krutikdg/airMouse/BOM.csv

Component | Quantity | Price/Unit (USD) | Purpose | Purchase Link
Seeed XIAO ESP32S3 (non-Sense version) | 1 | 27.20 | Main controller with Bluetooth LE and LiPo charging; the code and pin map assume this board | https://www.amazon.in/ESP32S3-2-4GHz-Wi-Fi-Dual-core-Supported-Efficiency-Interface/dp/B0BYSB66S5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
GY-521 MPU6050 gyro and accelerometer breakout | 1 | 8.55 | Reads wrist rotation to move the cursor | https://www.amazon.in/Gyroscope-Accelerometer-Interface-Tracking-Robotics/dp/B0H1JYZHGC
Mini analog thumb joystick module with push switch | 1 | 1.50 | Scroll on both axes and left click on press | https://www.amazon.in/Robocraze-Joystick-Breakout-Multi-Directional-High-Precision/dp/B073B647CW
Momentary tactile push button (about 6 x 6 mm) | 2 | 2 | Right click and clutch toggle | https://www.amazon.in/ElectroBot-Momentary-Tactile-Push-Button/dp/B07PRRRBRY
WS2812B addressable RGB LED | 1 | 2 | Clutch status and battery level indicator | https://hubtronics.in/neopixel-ws2811-led-strip-india
3.7V LiPo battery with protection circuit (502535 class, about 500 mAh) | 1 | 2.40 | Onboard power; its size sets the case dimensions | https://www.electropi.in/3.7v-500mah-lithium-polymer-lipo-rechargeable-battery-model-kp-502535?gad_source=4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
Mini slide switch (SPDT) | 1 | 1.10 | Main power on and off | https://www.amazon.in/Electronicspices-10pcs-Slide-Switch-3-Pin/dp/B08L56VG5B
100k ohm resistor pack | 1 | 2.15 | Battery voltage divider for the ADC | https://www.amazon.in/100k-100K-0-25W-metal-Resistor/dp/B0G4DLDMDC
M2 countersunk self tapping screw pack (about 6 to 8 mm long) | 1 | 1.5 | Fix the bottom cover to the case posts (4 needed) | https://robu.in/product/easymech-ss-304-csk-countersunk-philips-head-m2-x-8-mm-bolt-25-pcs/
Double sided foam tape | 1 | 0.95 | Hold the XIAO and battery in place | https://www.bigbasket.com/pd/40355872/nuovi-double-sided-foam-tape-24-mm-10-m-1-pc/?z=Ga9BX3pQL
Thin flexible hookup wire pack | 1 | 1.45 | Internal wiring inside the small case | https://www.flipkart.com/symfonia-combo-5-color-multi-strand-flexible-hookup-wire-7-36-2-meter-each-total-10-meter-full-copper-pvc-insulated-electric-model-bu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 | 1 | G | 11214002 | g | search | 782643135339 | c | &entryMethod=23231663444&&cmpid=content_23231663444_gmc_pla&gad_source=4&gad_campaignid=23231663444&gbraid=0AAAAADxRY58QNktJluO13a2g5Mcm0M6Fd&gclid=Cj0KCQiA5NXXBhDEARIsABAJhdLn7hGotIxUVWtY2uaqCcQ_-ERZuQnE59tPPa_knyNc-k_t3GVdzyQaAsJwEALw_wcB
