krutikdg/airMouse/CAD/airMouse_cover.step

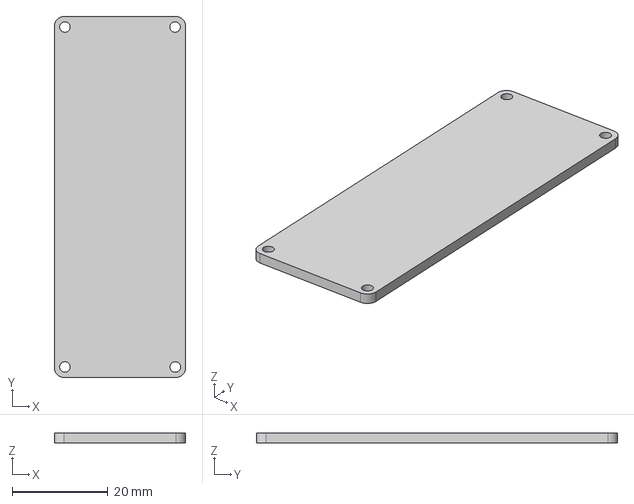
[picture p1: CAD file, 2026-11-12]
CAD/airMouse_cover.step
27.4 x 75.4 x 2.00 mm
