krutikdg/airMouse/CAD/airMouse_body.step

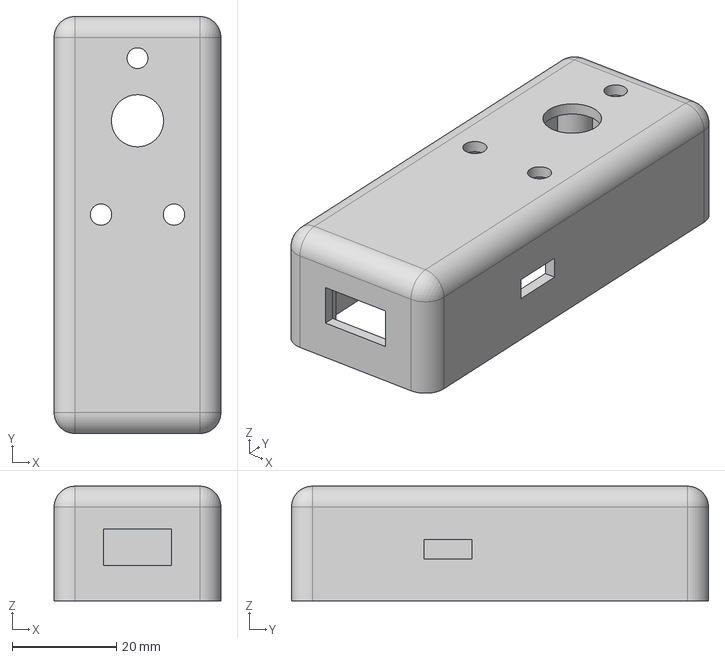
[picture p2: CAD file, 2026-11-12]
CAD/airMouse_body.step
32.0 x 80.0 x 22.0 mm
