krutikdg/airMouse/(list of files, cad)

Other CAD files:
CAD/airMouse_body.stl
CAD/airMouse_cover.stl
