krutikdg/airMouse/(commit log)

2026-11-12 added BOM.csv and updated README.md
    [BOM.csv]
2026-11-12 added CAD
    [airMouse_body.step, airMouse_body.stl, airMouse_cover.step, airMouse_cover.stl]
2026-11-12 Add CAD Models section to README
    Added CAD models section with images for body, cover, and complete.
